jurik555/3d_stol_meh/docs/side.png

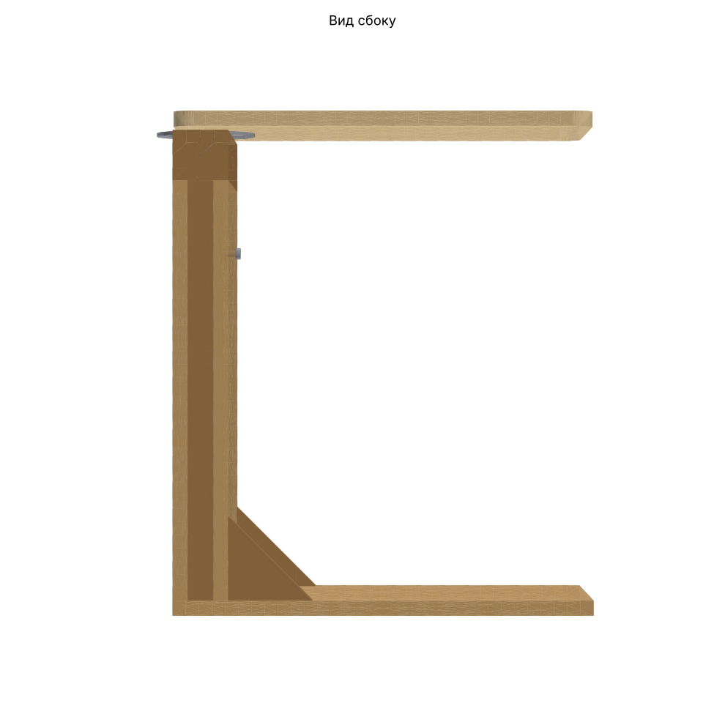
docs/side.png
