jurik555/3d_stol_meh/models/assembly_high_rotated.step

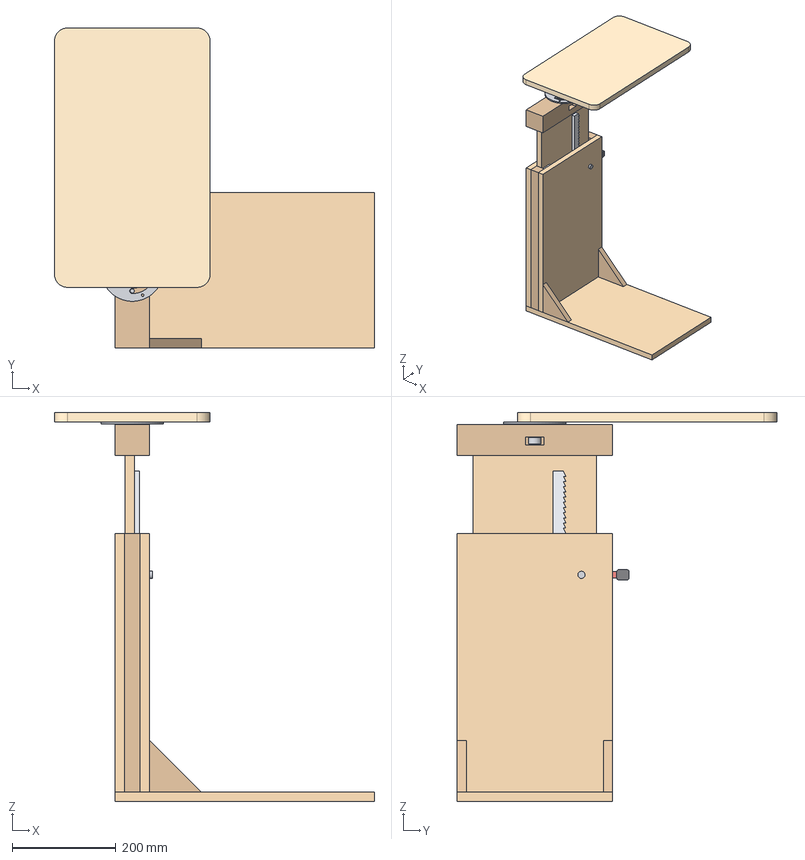
[picture p8: CAD file, 2026-10-15]
models/assembly_high_rotated.step
617.0 x 617.0 x 750.0 mm
base
stand_board_A
stand_board_B
spacer_left
spacer_right
gusset_left
gusset_right
guide_left
guide_right
pawl
lever_knob
pawl_pivot
spring_block
pawl_spring
gs_bracket_low
gas_spring_body
gas_spring_rod
mast
rack
gs_bracket_top
swivel_block
bushing
ball_plunger
stop_pin
ptfe_washer
nut_m16
flange
bolt_m16
tabletop
