jurik555/3d_stol_meh/(commit log)

2026-10-14 Параметрический генератор 3D-модели диванного столика (храповик + поворот)
    CadQuery-скрипт generate.py строит сборку в трёх положениях (низ, верх,
    верх с поворотом 90°) и экспортирует STEP, GLB, STL по деталям, DXF
    рейки/собачки/фланца, PNG-превью и спецификацию BOM.md.
    GitHub Action пересобирает модель при изменении параметров и по кнопке
    с вводом своих размеров.
    Claude-Session: https://claude.a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
2026-10-15 GLB-модели в models/ и ссылки на онлайн-просмотр
    Action после сборки коммитит обновлённые GLB в models/, README ссылается
    на gltf-viewer с raw-ссылками на эти файлы.
    Claude-Session: https://claude.ai/code/session_01Q4F2MJeGtR9TArTJVvoAyd
2026-10-15 STEP-сборки в models/, ссылки на 3dviewer.net
    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
    [assembly_high.step, assembly_high_rotated.step, assembly_low.step]
2026-10-15 Обновить модели в models/
    [assembly_high.step, assembly_high_rotated.step, assembly_low.step]
